golgoth31/domopool/wiring/ardipool/ardipool.kicad_pcb

## KiCad design wiring/ardipool/ardipool.kicad_pcb (2020-07-22)

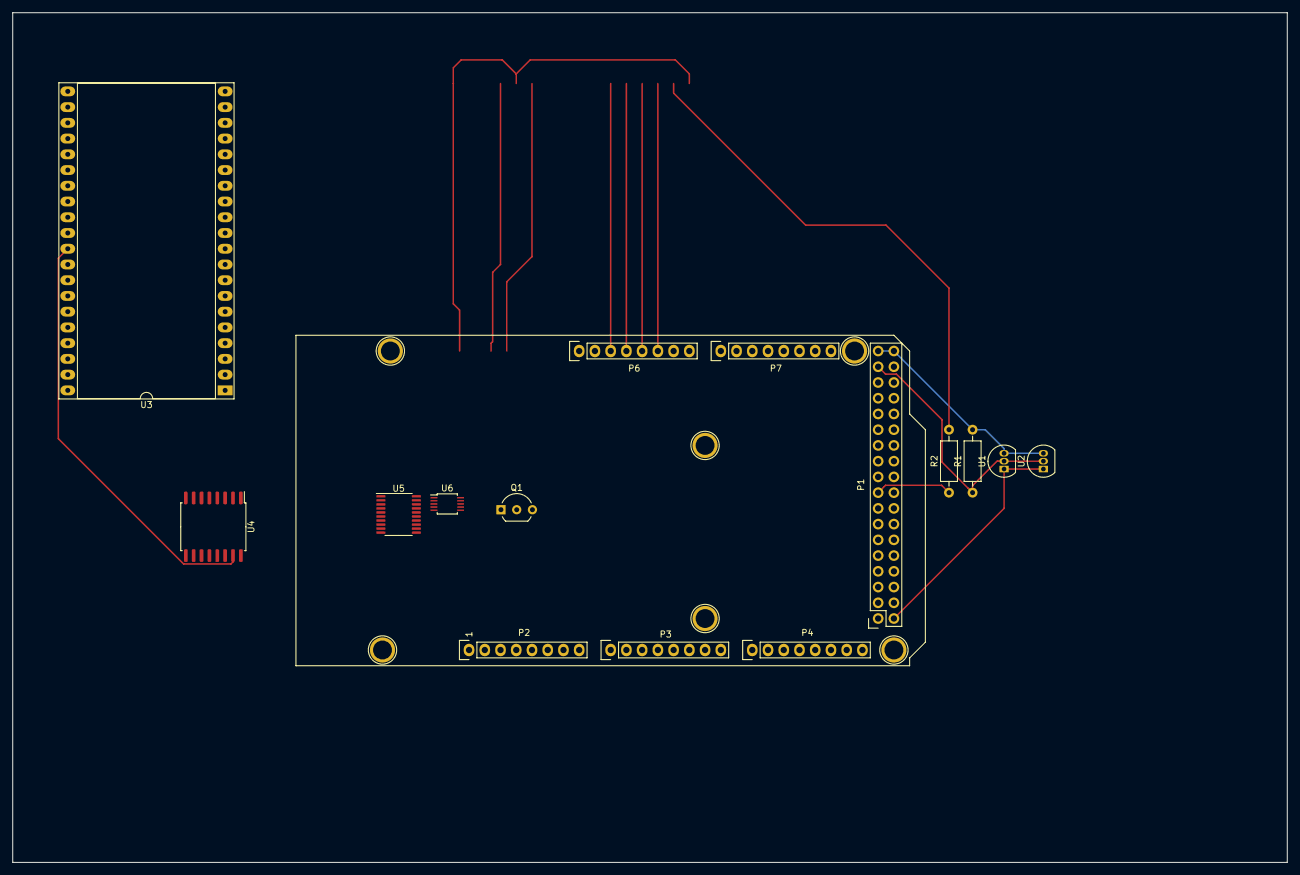
[picture p3: board ardipool.kicad_pcb from above]

Board: 2 copper layers, 205.7 x 137.2 mm, 21 parts (0 on the bottom side), 16 nets.

Parts:
P1: Digital; Socket_Strip_Arduino_2x18
P2: Power; Socket_Strip_Arduino_1x08
P3, P4: Analog; Socket_Strip_Arduino_1x08
P6: PWM; Socket_Strip_Arduino_1x08
P7: Communication; Socket_Strip_Arduino_1x08
P8, P9, P10, P11, P12, P13: CONN_01X01; Arduino_1pin
Q1: BC557; TO-92_Inline_Wide
R1: 4.7k; R_Axial_DIN0207_L6.3mm_D2.5mm_P10.16mm_Horizontal
R2: 1K; R_Axial_DIN0207_L6.3mm_D2.5mm_P10.16mm_Horizontal
U1, U2: DS18B20; TO-92_Inline
U3: ESP32devkitC; DIP-40_W25.4mm_Socket_LongPads
U4: DS3231M; SOIC-16W_7.5x10.3mm_P1.27mm
U5: TXS0108EPW; TSSOP-20_4.4x6.5mm_P0.65mm
U6: ADS1115IDGS; TSSOP-10_3x3mm_P0.5mm

Connections:
+3V3: P2.4, Q1.3, R1.2, U1.3, U2.3, U3.22, U4.2, U5.2
+5V: P1.35, P1.36, P2.5, U3.40, U5.19
DS18B20: P1.33, R1.1, U1.2, U2.2, U3.25
GND: P1.1, P1.2, P2.6, P2.7, U1.1, U2.1, U3.13, U3.19, U3.35, U4.5, U4.6, U4.7, U4.8, U4.9, U4.10, U4.11, U4.12, U4.13, U5.11
LED_32: R2.2, U3.4
unnamed: Q1.2, R2.1
unnamed: U5.12, U6.2
unnamed: U5.13, U6.1
unnamed: U5.14, U6.9
unnamed: U5.15, U6.10
Relay1-Filter: U3.36, U5.1
Relay2-ph: U3.37, U5.3
Relay3-ch: U3.38, U5.4
Relay4-light: U3.39, U5.5
SCL: P7.8, U3.32, U4.16, U5.6
SDA: P7.7, U3.31, U4.15, U5.7
