golgoth31/domopool/(commit log)

2020-05-05 make public
    [ardipool.kicad_pcb, ardipool.sch]
2020-05-06 lock filter pump on by 1 hour step
2020-05-06 add 1h step on filter pump
2020-05-07 first test for esp32
2020-05-09 start to add esp32 remove dht; use ds18b20 as ambiant temperature
2020-05-11 fix pump add alarm
    [main.cpp]
2020-05-19 start moving to esp32
2020-05-24 update to esp32
2020-06-18 fix chon down when filter pump down
2020-06-23 mv conf from arduinojson to preferences
2020-06-23 use prefs add api route for filter
2020-06-24 fix automatic pump switching add mqtt for metrics
    [main.cpp]
2020-06-25 remove eeprom calls in sensors
2020-06-26 update post handler for filter and mqtt
2020-06-26 fix keeping state when switching from automatic mode
2020-06-29 found bug in pref lib workaround on this bug
    [main.cpp]
2020-07-07 update network
    [ardipool.sch]
2020-07-15 various fix and update make rtc working start phy cable
    [main.cpp]
2020-07-16 make use of config.states
    [ardipool.sch]
2020-07-27 start to remove all arduinojson call
2020-08-03 rem arduinojson usage
2020-10-25 add water-pressure
2020-12-26 feat: Working without pressure
    [ardipool.sch]
2020-12-28 fix: Change to default on filter api
2020-12-30 fix: Water pressure
2021-01-04 refactor: Small refactor on filter pump
2021-01-13 fix: Fix network connect/disconnect
    [main.cpp]
2021-01-19 feat: Bump to proto v1.0.35 for adc config
2021-01-21 fix: Test on wp
    [main.cpp]
2021-01-22 feat: Add network to set adc config
2021-01-22 feat: Test on pressure
2021-01-22 fix: Wp by changing gain
    Set adc param for each measure
    [main.cpp]
2021-01-23 fix: Pressure and filter
    Slowdown adc to improve pressure precision
    Fix filter start/atop/auto
    [main.cpp]
2021-01-24 fix: Pump table
2021-01-25 feat: Add timestamp to metrics
    Fix ntp usage
    [main.cpp]
2021-01-25 fix: Try to fix mqtt alarms not sent
    [main.cpp]
2021-01-25 feat: Fix mqtt alarms
    [main.cpp]
2021-01-27 feat: Blank wp when starting filter
2021-01-28 fix: Hours for pump
    [main.cpp]
2021-02-27 fix: Reset wdt each 2s
    [main.cpp]
2021-03-03 fix: Wdt duration in config
    [main.cpp]
2021-03-30 fix: Force filter pump
    [main.cpp]
2021-04-25 fix: Typo on pump variables
2021-05-04 fix: Add temp sensors info to config
2021-06-25 feat: Unify filter, ch and ph api route
2021-06-25 feat: Add all relay action
2021-06-29 fix: Filter
2021-07-22 feat: Simplify relay start/stop
2021-09-15 feat: Bump arduinojson
2022-05-17 chore: Chg button name
2022-05-30 feat: Save twater when filter switch off
2022-11-13 fix: Display and pressure
